tomikaa87/esp-thermostat/README.md

# esp-thermostat
Smart WiFi thermostat based on the well-known ESP8266 SoC.

Documentation and detailed description will come in the near future...
