tomikaa87/esp-thermostat/doc/CR1632-holder-HTB1.jpg

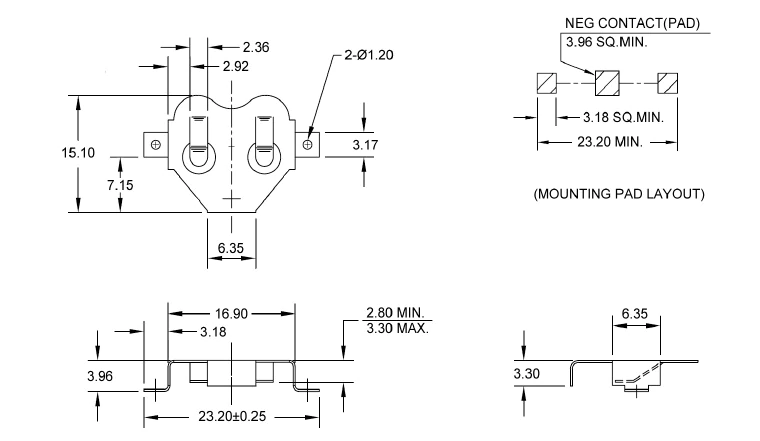
doc/CR1632-holder-HTB1.jpg
