tomikaa87/esp-thermostat/doc/oled-128x64-1.3inch.jpg

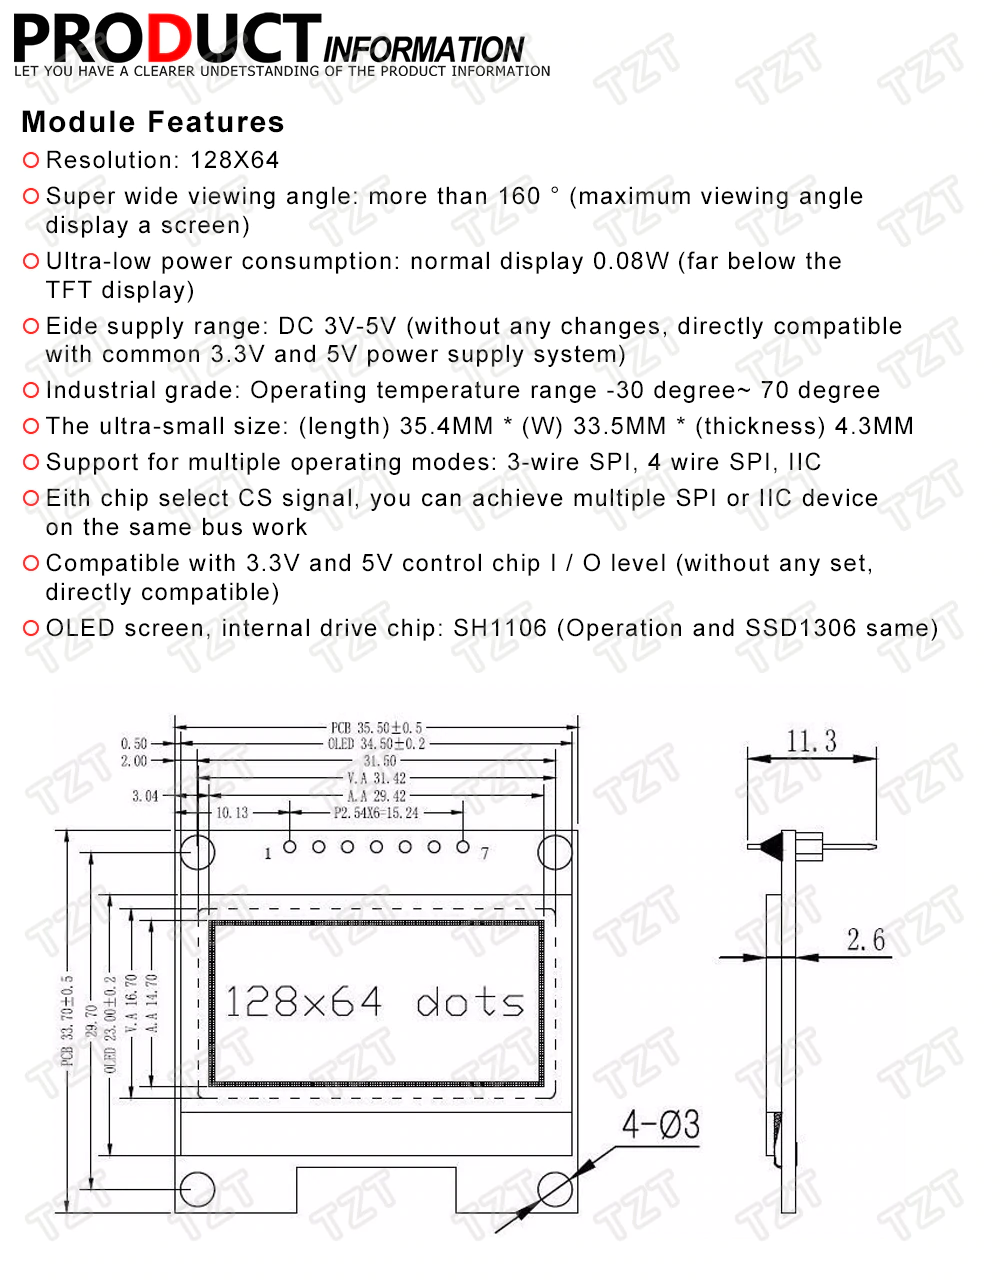
doc/oled-128x64-1.3inch.jpg
