tomikaa87/esp-thermostat/housing/esp-thermostat.FCStd

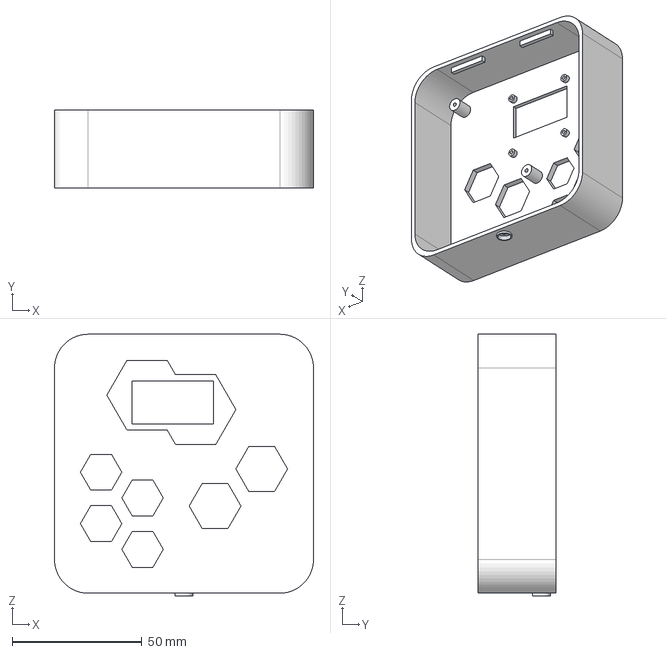
[picture p3: CAD file, 2019-12-08]
housing/esp-thermostat.FCStd
100.0 x 30.0 x 101.0 mm
