tomikaa87/esp-thermostat/pcb/esp-thermostat/ESP8266.3dshapes1/ESP-12.stl

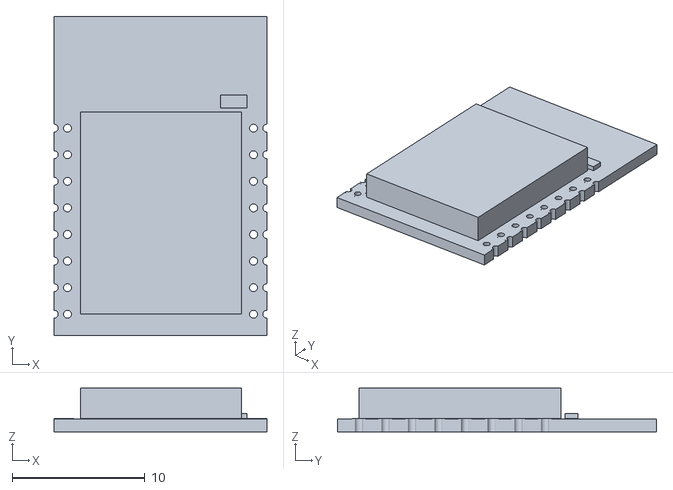
[picture p4: CAD file, 2019-11-27]
pcb/esp-thermostat/ESP8266.3dshapes1/ESP-12.stl
16.0 x 24.0 x 3.30
