tomikaa87/esp-thermostat/pcb/esp-thermostat/walter/conn_mkds/mkds_1,5-2.step

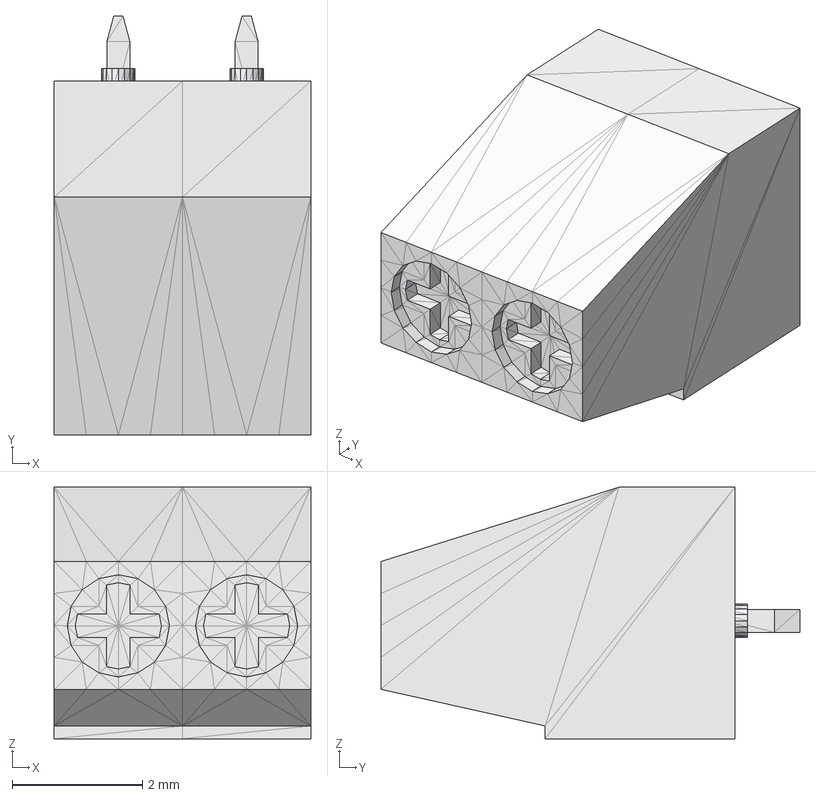
[picture p5: CAD file, 2019-11-27]
pcb/esp-thermostat/walter/conn_mkds/mkds_1,5-2.step
3.94 x 6.43 x 3.86 mm
mkds_1_5
mkds_1_006
mkds_1_007
mkds_1_008
mkds_1_009
mkds_1_010
mkds_1_011
mkds_1_012
mkds_1_013
mkds_1_014
mkds_1_015
mkds_1_016
mkds_1_017
