tomikaa87/esp-thermostat/(list of files, cad)

Other CAD files:
pcb/esp-thermostat/ESP8266.3dshapes1/ESP-12E_4wings.stl
pcb/esp-thermostat/ESP8266.3dshapes1/ESP-12_4wings.stl
pcb/esp-thermostat/ESP8266.3dshapes1/ESP-12E.stl
pcb/esp-thermostat/ESP8266.3dshapes1/ESP-12.scad
pcb/esp-thermostat/ESP8266.3dshapes1/ESP-12E.scad
pcb/esp-thermostat/walter/conn_mkds/mkds_1,5-2.stl
