tomikaa87/esp-thermostat/(threads)

Thread 2 (2024-06-16):

Please help resolve the issue with the new gree firmware: https://github.com/tomikaa87/gree-remote/issues/63

Tempmail1234-pass, 2024-06-16:

tomikaa87, 2024-10-01:
Not relevant to this project.

tomikaa87, 2024-10-01:
This issue is not relevant to the current project.

Closed 2024-10-01.
