tomikaa87/esp-thermostat/doc/switch-FSMJSM.pdf

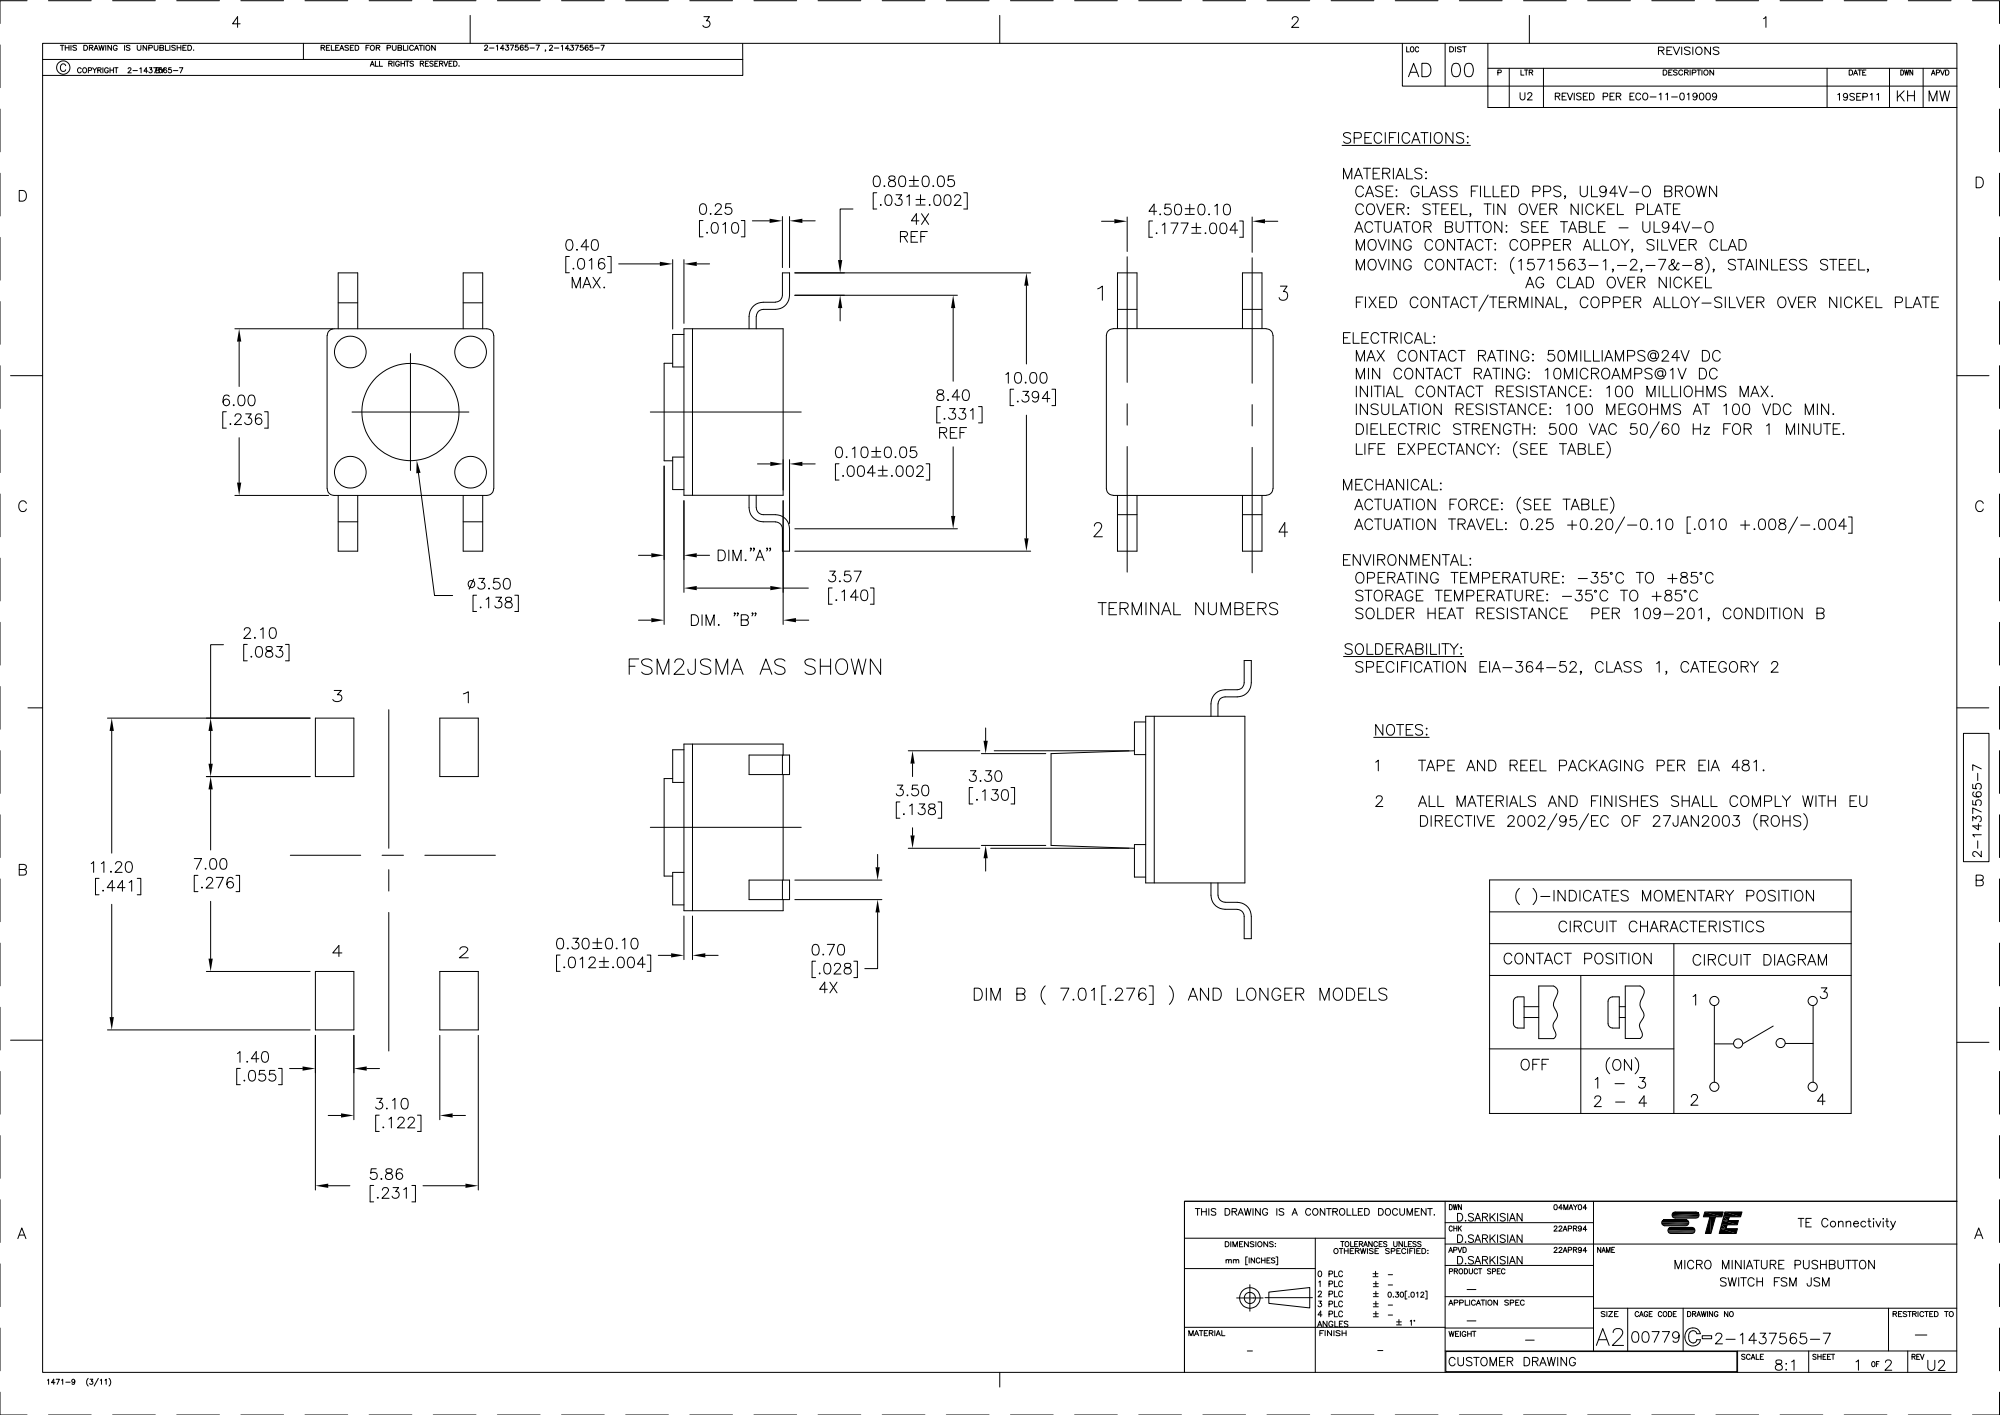
[picture p6: page 1]

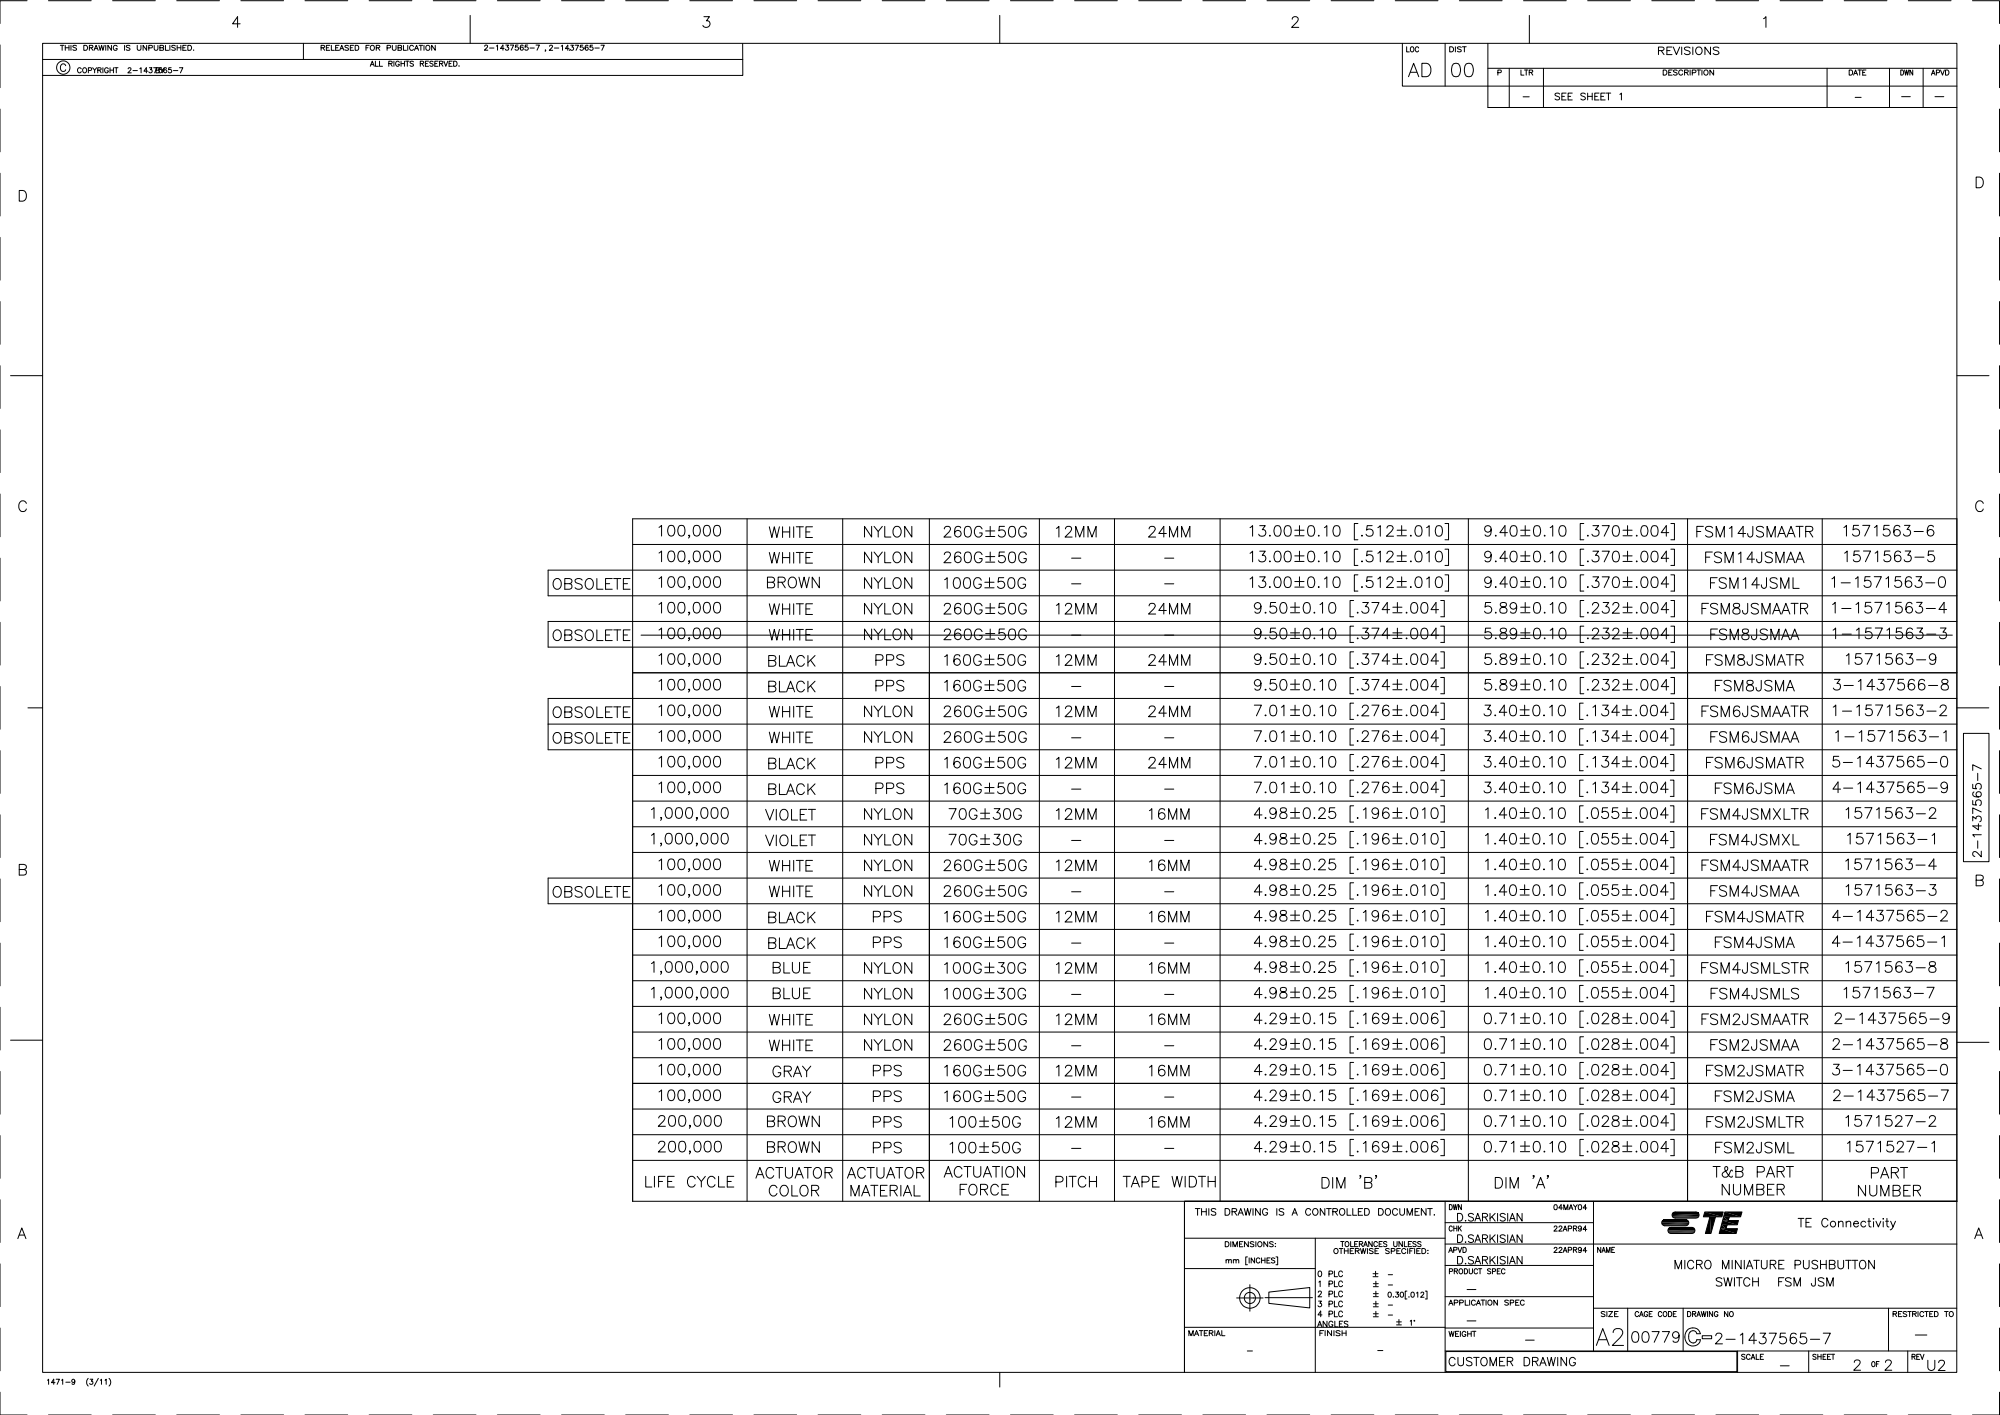
[picture p7: page 2]
