tomikaa87/esp-thermostat/pcb/esp-thermostat/esp-thermostat.kicad_pcb

## KiCad design pcb/esp-thermostat/esp-thermostat.kicad_pcb (2020-01-08)

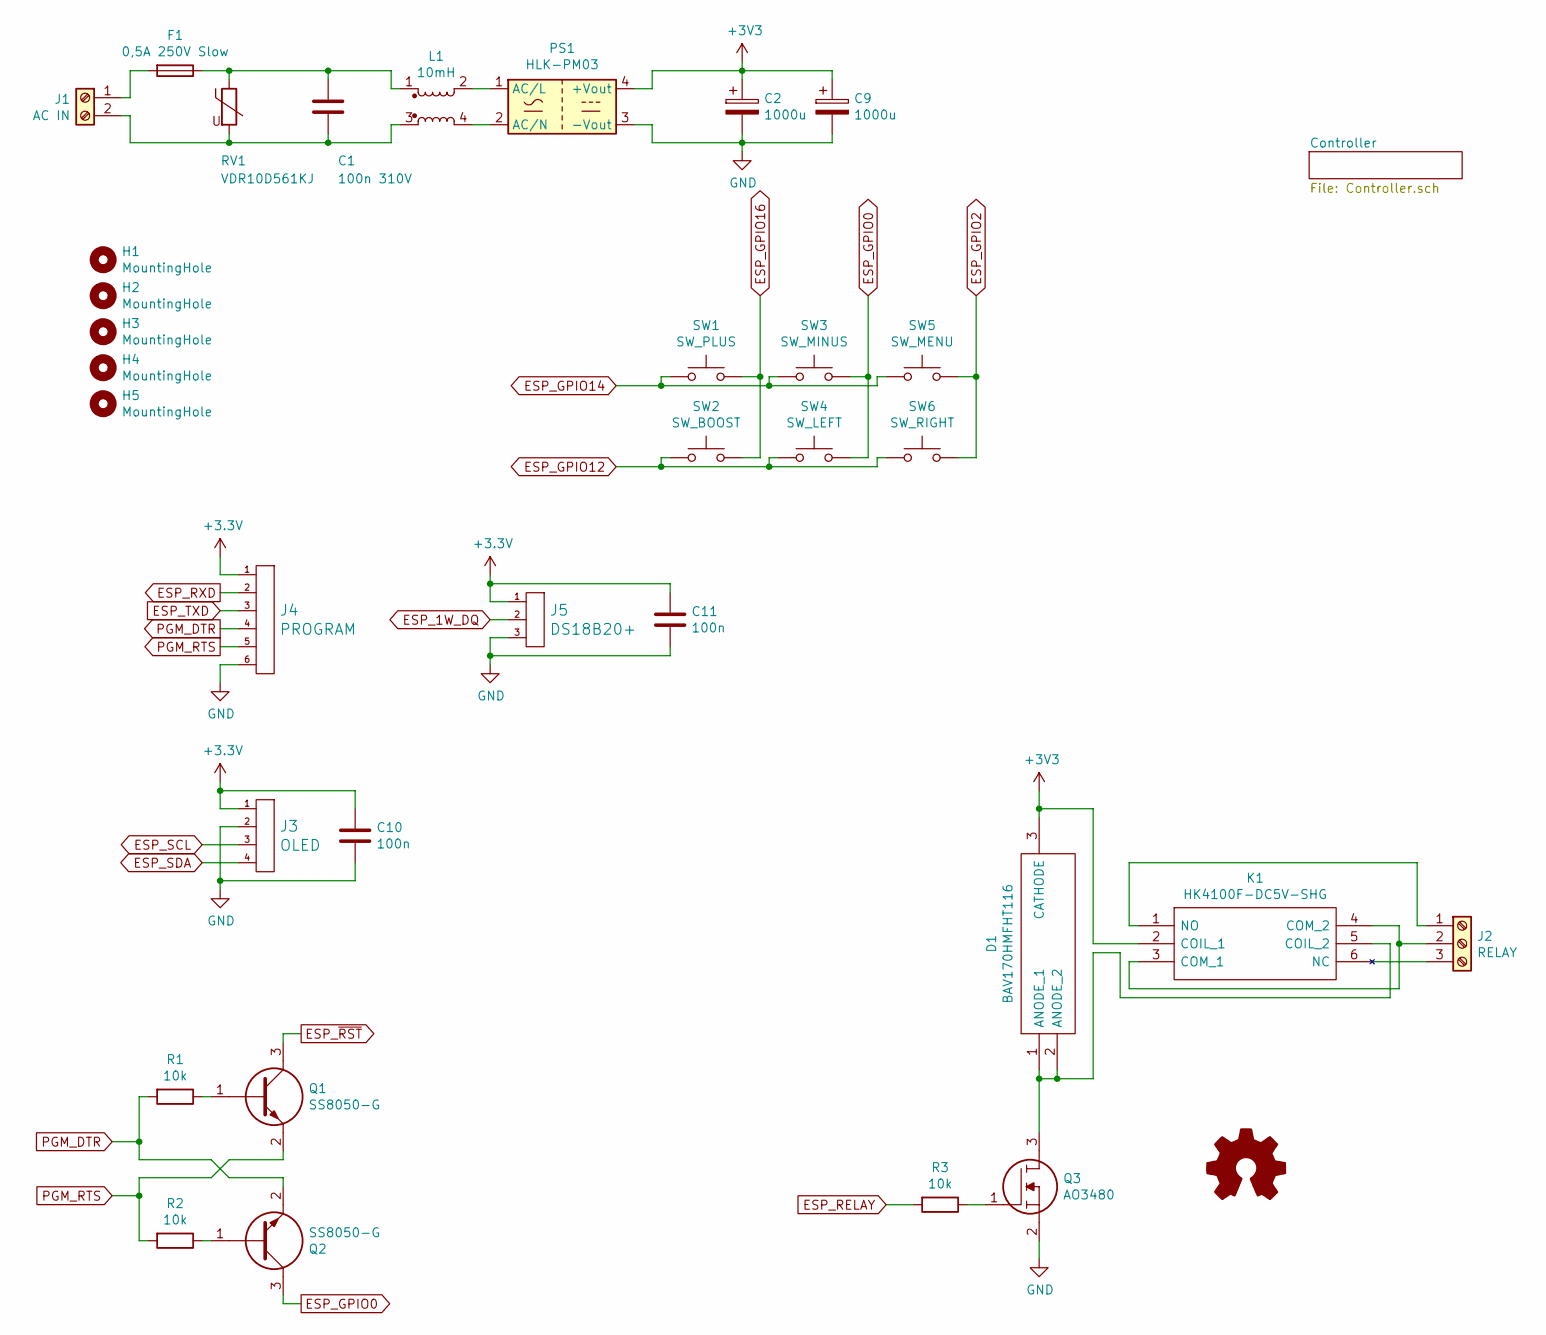
[picture p8: schematic esp-thermostat.sch]

Parts:
C1: 100n 310V; R46KI310040M1K
C2, C9: 1000u; CP_Radial_D10.0mm_P5.00mm
C10, C11: 100n; C_0805_2012Metric_Pad1.15x1.40mm_HandSolder
D1: BAV170HMFHT116; SOT95P240X115-3N; Manufacturer_Part_Number BAV170HMFHT116; Mouser Part Number 755-BAV170HMFHT116
F1: 0,5A 250V Slow; FUSC10134X305N
H1, H2, H3, H4, H5: MountingHole; MountingHole_3.2mm_M3_ISO14580_Pad
J1: AC IN; mkds_1,5-2
J2: RELAY; mkds_1,5-3
J3: OLED; PinHeader_1x04_P2.54mm_Vertical
J4: PROGRAM; PinHeader_1x06_P2.54mm_Vertical
J5: DS18B20+; PinHeader_1x03_P2.54mm_Vertical
K1: HK4100F-DC5V-SHG; HK4100FDC5VSHG; Manufacturer_Part_Number HK4100F-DC5V-SHG
L1: 10mH; UU9810MH
LOGO1: Logo_Open_Hardware_Small; OSHW-Logo2_14.6x12mm_SilkScreen
PS1: HLK-PM03; Converter_ACDC_HiLink_HLK-PMxx
Q1, Q2: SS8050-G; SOT95P240X115-3N; Manufacturer_Part_Number SS8050-G; Mouser Part Number 750-SS8050-G
Q3: AO3480; SOT95P280X125-3N; Manufacturer_Part_Number AO3480
R1, R2, R3: 10k; R_0805_2012Metric_Pad1.15x1.40mm_HandSolder
RV1: VDR10D561KJ; RV_Disc_D12mm_W6.7mm_P7.5mm
SW1: SW_PLUS; SW_Push_1P1T_NO_6x6mm_FSM2JSMA
SW2: SW_BOOST; SW_Push_1P1T_NO_6x6mm_FSM2JSMA
SW3: SW_MINUS; SW_Push_1P1T_NO_6x6mm_FSM2JSMA
SW4: SW_LEFT; SW_Push_1P1T_NO_6x6mm_FSM2JSMA
SW5: SW_MENU; SW_Push_1P1T_NO_6x6mm_FSM2JSMA
SW6: SW_RIGHT; SW_Push_1P1T_NO_6x6mm_FSM2JSMA

Connections:
ESP_1W_DQ: J5.2; also elsewhere on the board
ESP_GPIO0: Q2.3, SW3.2, SW4.2; also elsewhere on the board
ESP_GPIO2: SW5.2, SW6.2; also elsewhere on the board
ESP_GPIO12: SW2.1, SW4.1, SW6.1; also elsewhere on the board
ESP_GPIO14: SW1.1, SW3.1, SW5.1; also elsewhere on the board
ESP_GPIO16: SW1.2, SW2.2; also elsewhere on the board
ESP_RELAY: R3.2; also elsewhere on the board
ESP_RXD: J4.2; also elsewhere on the board
ESP_SCL: J3.3; also elsewhere on the board
ESP_SDA: J3.4; also elsewhere on the board
ESP_TXD: J4.3; also elsewhere on the board
ESP_~RST~: Q1.3; also elsewhere on the board
GND: C2.2, C9.2, C10.2, C11.2, J3.2, J4.6, J5.3, PS1.3 (-Vout), Q3.2; also elsewhere on the board
unnamed: C1.1, F1.1, L1.1, RV1.1
unnamed: C1.2, J1.2, L1.3, RV1.2
unnamed: D1.1 (ANODE_1), D1.2 (ANODE_2), K1.5 (COIL_2), Q3.3
unnamed: F1.2, J1.1
unnamed: J2.1, K1.1 (NO)
unnamed: J2.2, K1.3 (COM_1), K1.4 (COM_2)
unnamed: J2.3, K1.6 (NC)
unnamed: L1.2, PS1.1 (AC/L)
unnamed: L1.4, PS1.2 (AC/N)
unnamed: Q1.1, R1.1
unnamed: Q2.1, R2.1
unnamed: Q3.1, R3.1
PGM_DTR: J4.4, Q2.2, R1.2
PGM_RTS: J4.5, Q1.2, R2.2

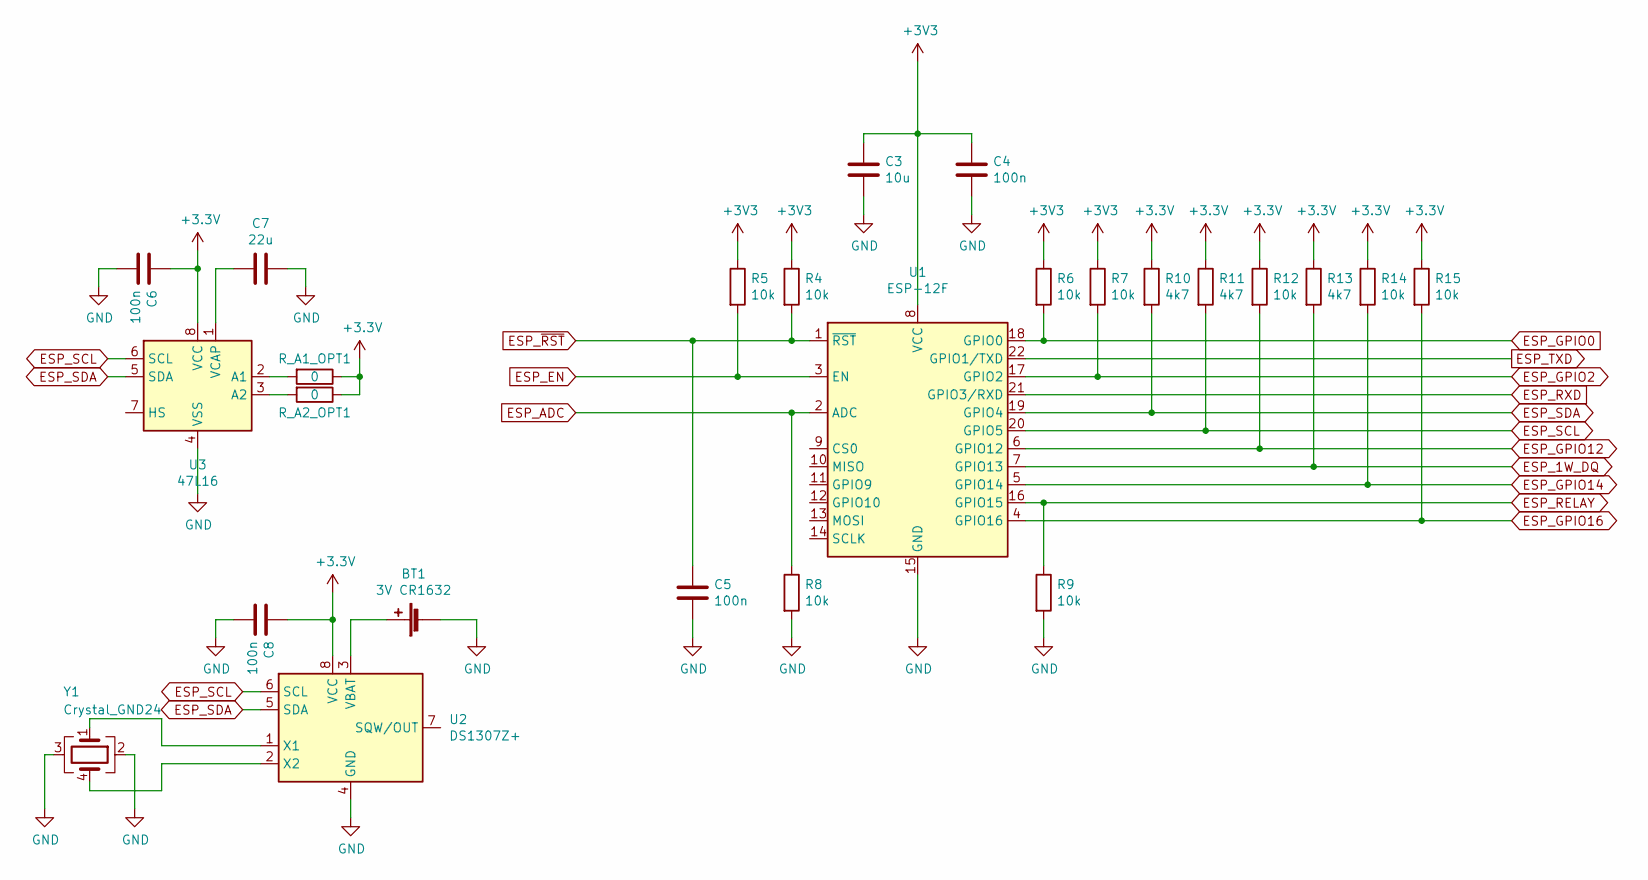
[picture p9: schematic Controller.sch]

Parts:
BT1: 3V CR1632; BatteryHolder_CR1632_SMD
C3: 10u; C_0805_2012Metric_Pad1.15x1.40mm_HandSolder
C4, C5, C6, C8: 100n; C_0805_2012Metric_Pad1.15x1.40mm_HandSolder
C7: 22u; C_0805_2012Metric_Pad1.15x1.40mm_HandSolder
R4, R5, R6, R7, R8, R9, R12, R14, R15: 10k; R_0805_2012Metric_Pad1.15x1.40mm_HandSolder
R10, R11, R13: 4k7; R_0805_2012Metric_Pad1.15x1.40mm_HandSolder
R_A1_OPT1, R_A2_OPT1: 0; R_0805_2012Metric_Pad1.15x1.40mm_HandSolder
U1: ESP-12F; ESP-12E_SMD
U2: DS1307Z+; SOIC-8_3.9x4.9mm_P1.27mm
U3: 47L16; SOIC-8_3.9x4.9mm_P1.27mm
Y1: Crystal_GND24; Crystal_SMD_SeikoEpson_MC306-4Pin_8.0x3.2mm

Connections:
ESP_1W_DQ: R13.2, U1.7 (GPIO13); also elsewhere on the board
ESP_ADC: R8.1, U1.2 (ADC)
ESP_EN: R5.2, U1.3 (EN)
ESP_GPIO0: R6.2, U1.18 (GPIO0); also elsewhere on the board
ESP_GPIO2: R7.2, U1.17 (GPIO2); also elsewhere on the board
ESP_GPIO12: R12.2, U1.6 (GPIO12); also elsewhere on the board
ESP_GPIO14: R14.2, U1.5 (GPIO14); also elsewhere on the board
ESP_GPIO16: R15.2, U1.4 (GPIO16); also elsewhere on the board
ESP_RELAY: R9.1, U1.16 (GPIO15); also elsewhere on the board
ESP_RXD: U1.21 (GPIO3/RXD); also elsewhere on the board
ESP_SCL: R11.2, U1.20 (GPIO5), U2.6 (SCL), U3.6 (SCL); also elsewhere on the board
ESP_SDA: R10.2, U1.19 (GPIO4), U2.5 (SDA), U3.5 (SDA); also elsewhere on the board
ESP_TXD: U1.22 (GPIO1/TXD); also elsewhere on the board
ESP_~RST~: C5.1, R4.2, U1.1 (~RST); also elsewhere on the board
GND: BT1.2 (-), C3.2, C4.2, C5.2, C6.2, C7.1, C8.2, R8.2, R9.2, U1.15 (GND), U2.4 (GND), U3.4 (VSS), Y1.2, Y1.3; also elsewhere on the board
unnamed: BT1.1 (+), U2.3 (VBAT)
unnamed: C7.2, U3.1 (VCAP)
unnamed: R_A1_OPT1.2, U3.2 (A1)
unnamed: R_A2_OPT1.2, U3.3 (A2)
unnamed: U2.1 (X1), Y1.1
unnamed: U2.2 (X2), Y1.4

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
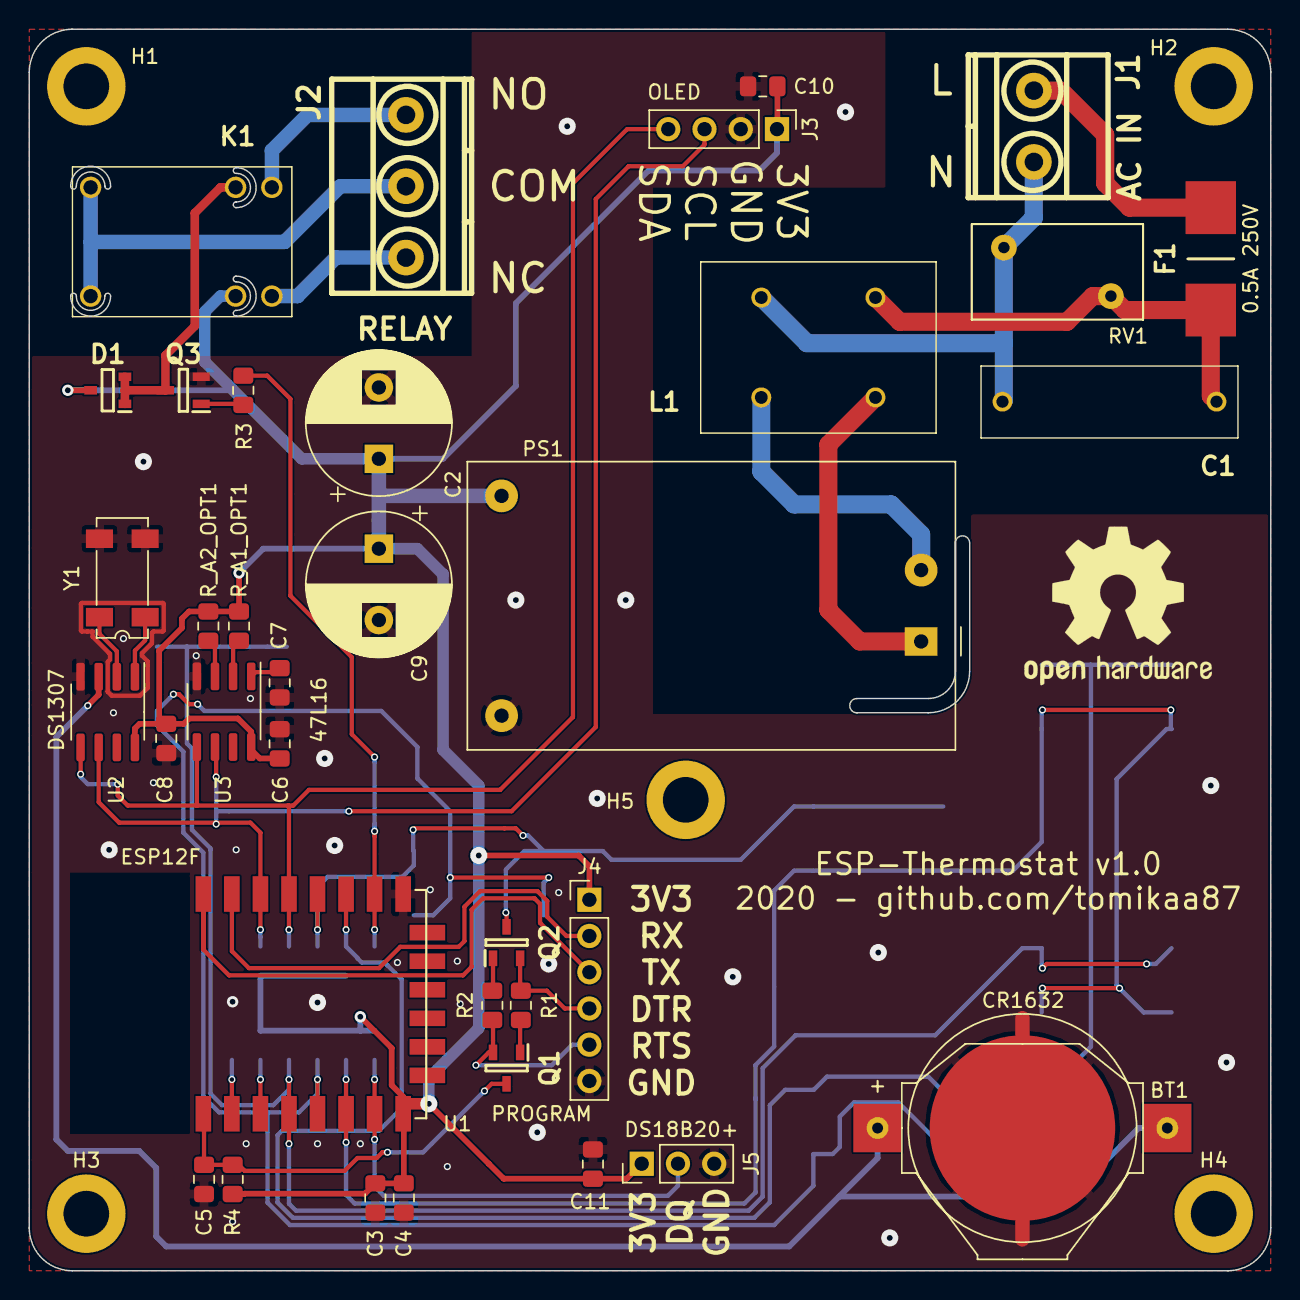
[picture p10: board esp-thermostat.kicad_pcb from above]

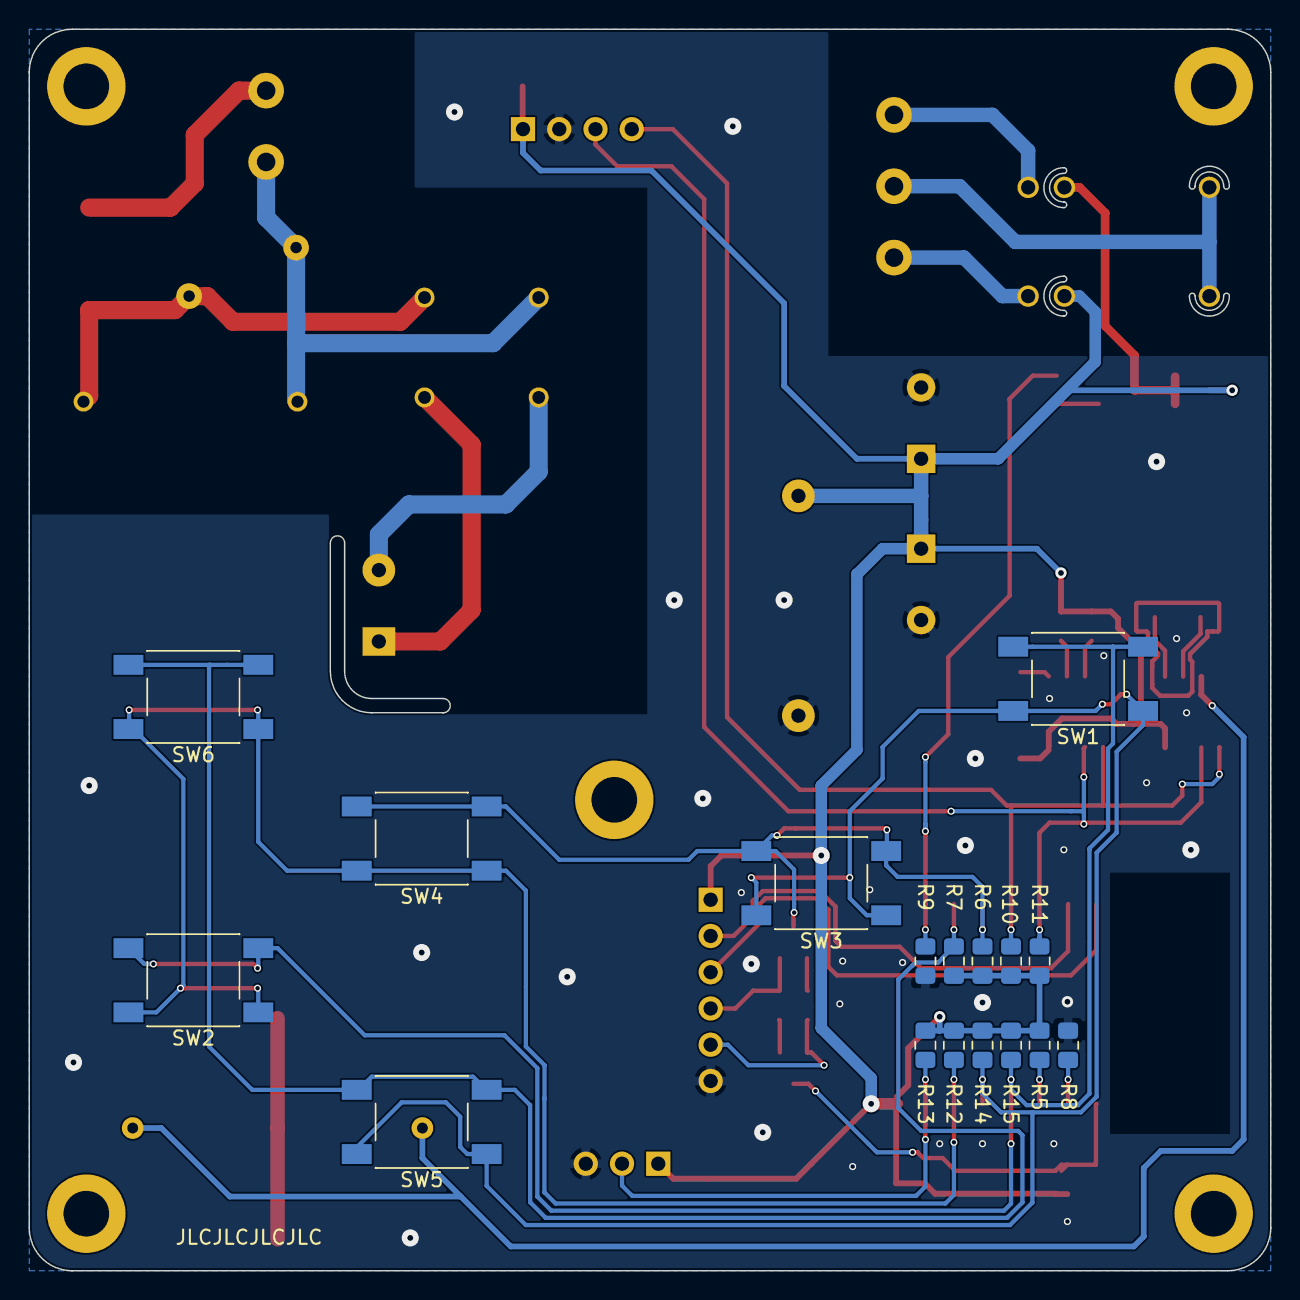
[picture p11: board esp-thermostat.kicad_pcb from below]

Board: 2 copper layers, 87.0 x 87.0 mm, 59 parts (17 on the bottom side), 36 nets.
