tomikaa87/esp-thermostat/src/main.cpp

#include "main.h"
#include "Config.h"
#include "FurnaceController.h"
#include "Peripherals.h"
#include "Settings.h"

#include "ui/Model.h"
#include "ui/UIController.h"

#include <Arduino.h>
#include <CoreApplication.h>

#include <memory>

namespace
{
    ApplicationConfig appConfig;
    CoreApplication* coreApplication{};
    Settings* settings{};
    UI::Model* uiModel{};
    FurnaceController* furnaceController{};
    UI::UIController* uiController{};
}

void initializeTempSensor()
{
    // Force a new conversion and wait for the results
    Peripherals::Sensors::MainTemperature::update(true);
    delay(800); // Max. 750 ms for 12-bit
    Peripherals::Sensors::MainTemperature::update();
}

void setup()
{
    initializeTempSensor();

    appConfig.firmwareVersion = VersionNumber{ 1, 8, 0 };

#ifndef TEST_BUILD
    appConfig.logging.syslog.enabled = true;
    appConfig.logging.syslog.hostName = Config::Logging::SyslogHostName;
    appConfig.logging.syslog.server = Config::Logging::SyslogServer;
    appConfig.logging.syslog.serverPort = Config::Logging::SyslogServerPort;
#endif

    appConfig.mqtt.enabled = Config::Mqtt::Enabled;
    if (Config::Mqtt::Enabled) {
        appConfig.mqtt.id = Config::Mqtt::Id;
        appConfig.mqtt.broker = Config::Mqtt::Broker;
        appConfig.mqtt.brokerPort = Config::Mqtt::BrokerPort;
        appConfig.mqtt.user = Config::Mqtt::User;
        appConfig.mqtt.password =  Config::Mqtt::Password;
    }

#ifdef IOT_ENABLE_HTTP_OTA_UPDATE
    appConfig.otaUpdate.updateCheckIntervalMs = 60000;
    appConfig.otaUpdate.updateUrl = Config::OtaUpdate::FirmwareUpdateUrl;
#endif
    appConfig.otaUpdate.arduinoOtaPasswordHash = Config::OtaUpdate::ArduinoOtaPasswordHash;

    appConfig.wifi.password = Config::WiFi::Password;
    appConfig.wifi.ssid = Config::WiFi::SSID;

    appConfig.ntp.server = Config::Ntp::Server;

    appConfig.hostName = Config::HostName;

    coreApplication = [] {
        static CoreApplication application{ appConfig };
        return &application;
    }();

    settings = [] {
        static Settings s{ coreApplication->settings() };
        return &s;
    }();

    appConfig.logging.maximumLevel = static_cast<Log::Severity>(settings->system.maximumLogLevel);

    uiModel = [] {
        static UI::Model model{ .settings = *settings };
        return &model;
    }();

    furnaceController = [] {
        static FurnaceController controller{ *coreApplication, appConfig, *settings, *uiModel };
        return &controller;
    }();

    uiController = [] {
        static UI::UIController controller{ *coreApplication, *settings, *uiModel };
        return &controller;
    }();
}

void loop()
{
    static uint32_t lastTaskMillis{};

    const uint32_t currentMillis{ millis() };
    const uint32_t deltaMillis{ currentMillis - lastTaskMillis };
    lastTaskMillis = currentMillis;

    coreApplication->task();
    furnaceController->task(deltaMillis);
    uiController->task(deltaMillis);
}
