tomikaa87/esp-thermostat/src/FurnaceController.h

#pragma once

#include "Config.h"
#include "HeatingZone.h"
#include "Settings.h"
#include "TemperatureSensor.h"

#include <CoreApplication.h>
#include <Logger.h>

#include <network/MQTT/MqttVariable.h>

#include <array>
#include <cstdint>

class ApplicationConfig;

namespace UI
{
    struct Model;
}

class FurnaceController
{
public:
    explicit FurnaceController(
        CoreApplication& application,
        const ApplicationConfig& appConfig,
        Settings& settings,
        UI::Model& uiModel
    );

    void task(uint32_t deltaMillis);

private:
    const ApplicationConfig& _appConfig;
    CoreApplication& _app;
    Settings& _settings;
    UI::Model& _uiModel;
    Logger _log{ "FurnaceController" };
    std::array<HeatingZone, Config::ZoneCount> _zones;
    TemperatureSensor _temperatureSensor;
    uint32_t _mqttUpdateTimer{};
    uint32_t _clockUpdateTimer{};
    bool _relayOutputActive{ false };

    std::string _topicPrefix;
    MqttVariable<int> _masterSwitch;
    MqttVariable<int> _energyOptimizerSwitch;
    MqttVariable<int> _callingForHeatingState;

    void setupRelayOutput() const;
    void setRelayOutputActive(bool active);

    void setupMqttComponentConfigs();
    void setupMqttChangeHandlers();
    void updateMqtt();

    void updateUiModel();
};
