tomikaa87/esp-thermostat/src/wifi_screen.cpp

/*
    This file is part of esp-thermostat.

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
    Author: Tamas Karpati
    Created on 2020-01-08
*/

#include "keypad.h"
#include "text_input.h"
#include "wifi_screen.h"

#include "display/Display.h"
#include "display/Text.h"

#include <string.h>
#include <stdio.h>

/*
    Main screen:

    WiFi Connection
    Connected to:
    <SSID>
    IP: 000.000.000.000

    > Disconnect
      Scan
      Leave


    Scan screen (scanning):

    WiFi Networks:
    
    Scanning...

    > Abort


    Scan screen (found networks):

    WiFi Networks:
    > SSID 1
      SSID 2
      SSID 3
      SSID 4
      SSID 5
      Back
      


*/

typedef enum {
    SCR_MAIN,
    SCR_SCAN,
    SCR_PASSWORD
} screen_t;

typedef enum {
    SCN_IDLE,
    SCN_SCANNING,
    SCN_FINISHED
} scan_state_t;

static struct state_s {
    int ap_cnt;
    char ap_psk[64];
    char ap_ssid[32];
    int list_pos;
    int list_offs;
    screen_t screen;
    scan_state_t scan;
} state;

static struct cb_s {
    wifi_scan_cb scan;
    wifi_read_ssid_cb read_ssid;
    wifi_is_open_cb is_open;
} callbacks;

static void draw();
static void update();
static void select_item();
static void init_scan();

void wifi_screen_set_scan_cb(wifi_scan_cb cb)
{
    callbacks.scan = cb;
}

void wifi_screen_set_read_ssid_cb(wifi_read_ssid_cb cb)
{
    callbacks.read_ssid = cb;
}

void wifi_screen_set_is_open_cb(wifi_is_open_cb cb)
{
    callbacks.is_open = cb;
}

void wifi_screen_init()
{
    printf("wifi_screen::init\n");

    memset(&state, 0, sizeof(struct state_s));

    draw();
}

void wifi_screen_update()
{
    printf("wifi_screen::update\n");
}

void wifi_screen_leave()
{
    printf("wifi_screen::leave\n");
}

void wifi_screen_key_event(Keypad::Keys keys)
{
    printf("wifi_screen::key_event: keys=0x%x\n", keys);

    bool update_needed = false;

    switch (state.screen) {
    case SCR_MAIN:
        // + -> Down
        if (keys & Keypad::Keys::Plus) {
            if (++state.list_pos >= 3) {
                state.list_pos = 0;
            }
            update_needed = true;
        // - -> Up
        } else if (keys & Keypad::Keys::Minus) {
            if (state.list_pos == 0) {
                state.list_pos = 2;
            } else {
                --state.list_pos;
            }
            update_needed = true;
        // Right -> Select
        } else if (keys & Keypad::Keys::Right) {
            select_item();
        }
        break;

    case SCR_SCAN:
        // + -> Down
        if (keys & Keypad::Keys::Plus) {
            if (state.list_pos < state.ap_cnt) {
                ++state.list_pos;
                if (state.list_pos - state.list_offs > 6) {
                    ++state.list_offs;
                }
            }
            update_needed = true;
        // - -> Up
        } else if (keys & Keypad::Keys::Minus) {
            if (state.list_pos > 0) {
                --state.list_pos;
                if (state.list_pos - state.list_offs < 0) {
                    --state.list_offs;
                }
            }
            update_needed = true;
        } else if (keys & Keypad::Keys::Right) {
            select_item();
        }

    case SCR_PASSWORD: {
        ti_key_event_t key_event;
        bool valid_key = true;

        if (keys & Keypad::Keys::Plus) {
            key_event = TI_KE_UP;
        } else if (keys & Keypad::Keys::Minus) {
            key_event = TI_KE_DOWN;
        } else if (keys & Keypad::Keys::Menu) {
            key_event = TI_KE_SELECT;
        } else if (keys & Keypad::Keys::Left) {
            key_event = TI_KE_LEFT;
        } else if (keys & Keypad::Keys::Right) {
            key_event = TI_KE_RIGHT;
        } else {
            valid_key = false;
        }

        if (valid_key) {
            const ti_key_event_result_t res = text_input_key_event(key_event);

            switch (res) {
            case TI_KE_ACCEPT:
                printf("wifi_screen: password entered: %s\n", state.ap_psk);
                state.screen = SCR_MAIN;
                draw();
                break;

            case TI_KE_CANCEL:
                printf("wifi_screen: password input canceled\n");
                state.screen = SCR_SCAN;
                draw();
                break;

            default:
                break;
            }
        }
        break;
    }        
    }

    if (update_needed) {
        update();
    }
}

static void draw()
{
    printf("wifi_screen::draw: screen=%d\n", state.screen);

    Display::clear();

    switch (state.screen) {
    case SCR_MAIN:
        Text::draw("WiFi Connection", 0, 0, 0, false);
        Text::draw("Connected to:", 1, 0, 0, false);
        Text::draw("IP:", 3, 0, 0, false);
        Text::draw("Disconnect", 5, 10, 0, false);
        Text::draw("Scan", 6, 10, 0, false);
        Text::draw("Leave", 7, 10, 0, false);
        break;

    case SCR_SCAN:
        Text::draw("WiFi Networks", 0, 0, 0, false);
        switch (state.scan) {
        case SCN_IDLE:
            Text::draw("Idle", 2, 10, 0, false);
            break;

        case SCN_SCANNING:
            Text::draw("Scanning...", 2, 10, 0, false);
            break;
        }
        break;

    case SCR_PASSWORD:
        text_input_init(state.ap_psk, sizeof(state.ap_psk), "WiFi Password:");
        break;
    }

    update();
}

static void update()
{
    printf("wifi_screen::update: screen=%d\n", state.screen);

    switch (state.screen) {
    case SCR_MAIN:
        for (int i = 0; i < 3; ++i) {
            Text::draw(i == state.list_pos ? ">" : " ", i + 5, 0, 0, false);
        }
        break;

    case SCR_SCAN:
        switch (state.scan) {
        case SCN_FINISHED:
            for (int i = state.list_offs, line = 1; i < state.ap_cnt + 1 && i - state.list_offs < 7; ++i, ++line) {
                printf("wifi_screen::update: drawing AP list item, i=%d, list_pos=%d, list_offs=%d, line=%d\n",
                    i, state.list_pos, state.list_offs, line
                );

                // Clear the row
                Display::setColumn(10);
                Display::setLine(line);
                for (int i = 0; i < 118; ++i) {
                    static const uint8_t pattern = 0;
                    Display::sendData(&pattern, 1, 0, false);
                }

                if (i == 0) {
                    Text::draw("<< Back", line, 10, 0, false);
                } else {
                    if (callbacks.read_ssid) {
                        char buf[32] = { 0 };
                        callbacks.read_ssid(i - 1, buf);
                        Text::draw(buf, line, 10, 0, false);
                    }
                }
                Text::draw(i == state.list_pos ? ">" : " ", line, 0, 0, false);
            }
            break;
        }
        break;
    }
}

static void select_item()
{
    printf("wifi_screen::select_item: %d\n", state.list_pos);

    switch (state.screen) {
    case SCR_MAIN:
        if (state.list_pos == 0) {
            // Disconnect
        } else if (state.list_pos == 1) {
            // Scan
            state.screen = SCR_SCAN;
            draw();
            init_scan();
        } else if (state.list_pos == 2) {
            // Leave
        }
        break;

    case SCR_SCAN:
        if (state.list_pos == 0) {
            // Back
            state.screen = SCR_MAIN;
            draw();
        } else {
            // Select SSID
            if (callbacks.read_ssid) {
                callbacks.read_ssid(state.list_pos - 1, state.ap_ssid);
                printf("wifi_screen::select_item: selected SSID: %s\n", state.ap_ssid);
            }

            if (callbacks.is_open) {
                if (!callbacks.is_open(state.list_pos - 1)) {
                    printf("wifi_screen::select_item: selected AP requires password\n");
                    state.screen = SCR_PASSWORD;
                    text_input_init(state.ap_psk, sizeof(state.ap_psk), "Enter password:");
                } else {
                    state.screen = SCR_MAIN;
                    printf("wifi_screen::select_item: selected AP is open\n");
                    draw();
                }
            }
        }
        break;
    }
}

static void init_scan()
{
    printf("wifi_screen::init_scan\n");

    state.scan = SCN_IDLE;
    state.ap_cnt = 0;
    state.list_offs = 0;

    update();

    if (callbacks.scan) {
        state.scan = SCN_SCANNING;
        update();
        printf("wifi_screen::init_scan: scanning\n");
        state.ap_cnt = callbacks.scan();
        printf("wifi_screen::init_scan: finished, count=%d\n", state.ap_cnt);
        state.scan = SCN_FINISHED;
        update();
    } else {
        printf("wifi_screen::init_scan: scan callback is null\n");
    }
}
