tomikaa87/esp-thermostat/src/draw_helper.cpp

/*
    This file is part of esp-thermostat.

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
    Author: Tamas Karpati
    Created on 2017-01-07
*/

#include "draw_helper.h"
#include "graphics.h"
#include "extras.h"

#include "display/Display.h"
#include "display/Text.h"

#include <stdio.h>

void draw_weekday(uint8_t x, uint8_t wday)
{
    if (wday > 6)
        return;

    static const char days[7][4] = {
        "SUN",
        "MON",
        "TUE",
        "WED",
        "THU",
        "FRI",
        "SAT"
    };

    Text::draw(days[wday], 0, x, 0, false);
}

void draw_mode_indicator(mode_indicator_t indicator)
{
    switch (indicator) {
    case DH_MODE_HEATING:
        graphics_draw_multipage_bitmap(graphics_flame_icon_20x3p, 20, 3, 92, 2);
        break;

    case DH_MODE_OFF:
        graphics_draw_multipage_bitmap(graphics_off_icon_20x3p, 20, 3, 92, 2);
        break;

    default:
        Display::fillArea(92, 2, 20, 3, 0);
        break;
    }
}

void draw_schedule_bar(schedule_day_data sday)
{
    static const uint8_t long_tick = 0b11110000;
    static const uint8_t short_tick = 0b01110000;
    static const uint8_t bar_indicator = 0b00010111;
    static const uint8_t bar_no_indicator = 0b00010000;

    Display::setLine(6);
    Display::setColumn(3);

    uint8_t tick_counter = 0;
    uint8_t long_tick_counter = 0;
    uint8_t schedule_byte_idx = 0;
    uint8_t schedule_bit_idx = 255; // Will overflow in the first round
    uint8_t indicator_counter = 0;
    uint8_t schedule_bit = 0;

    for (uint8_t x = 0; x < 121; ++x) {
        uint8_t bitmap;

        if (tick_counter == 0) {
            // Draw ticks
            if (long_tick_counter == 0)
                bitmap = long_tick;
            else
                bitmap = short_tick;
        } else {
            // Draw rest of the bar with or without the indicators
            if (indicator_counter < 2 && schedule_bit)
                bitmap = bar_indicator;
            else
                bitmap = bar_no_indicator;
        }

        Display::sendData(bitmap);

        if (++tick_counter == 5) {
            tick_counter = 0;
            if (++long_tick_counter == 6)
                long_tick_counter = 0;
        }

        ++indicator_counter;
        if (tick_counter == 1 || tick_counter == 3) {
            indicator_counter = 0;
            if (++schedule_bit_idx == 8) {
                ++schedule_byte_idx;
                schedule_bit_idx = 0;
            }

            schedule_bit = (sday[schedule_byte_idx] >> schedule_bit_idx) & 1;
        }
    }

    Text::draw("0", 7, 1, 1, false);
    Text::draw("6", 7, 31, 1, false);
    Text::draw("12", 7, 58, 1, false);
    Text::draw("18", 7, 88, 1, false);
    Text::draw("24", 7, 115, 1, false);
}

void draw_schedule_indicator(uint8_t sch_intval_idx)
{
    static const uint8_t indicator_bitmap[] = {
        0b00010000,
        0b00100000,
        0b01111100,
        0b00100000,
        0b00010000
    };

    uint8_t x = 2; // initial offset from left
    x += sch_intval_idx << 1;	// for every "tick"
    x += sch_intval_idx >> 1;	// for every padding between "ticks"

    /*
     0:     v
     1:     . v
     2:     . .  v
     3:     . .  . v
     4:     . .  . .  v
     5:     . .  . .  . v
            |||| |||| ||||
            01234567890123

        0 -> 0
        1 -> 2
        2 -> 5
        3 -> 7
        4 -> 10
        5 -> 12
     */

    Display::fillArea(0, 5, 128, 1, 0);

    graphics_draw_bitmap(indicator_bitmap, sizeof(indicator_bitmap), x, 5);
}

void draw_temperature_value(uint8_t x, int8_t int_part, int8_t frac_part)
{
    if (int_part < 0 || frac_part < 0)
        Text::draw7Seg("-", 2, x - 13);
    else
        Text::draw7Seg(" ", 2, x - 13);

    // Draw integral part of the value
    char s[3] = { 0 };
    sprintf(s, "%02d", int_part >= 0 ? int_part : -int_part);
    Text::draw7Seg(s, 2, x);

    // Draw the decimal point
    static const uint8_t dp_bitmap[] = { 0b01100000, 0b01100000 };
    Display::setLine(4);
    Display::setColumn(x + 28);
    Display::sendData(dp_bitmap, sizeof(dp_bitmap), 0, false);

    // Draw fractional part of the value
    sprintf(s, "%d", frac_part >= 0 ? frac_part : -frac_part);
    Text::draw7Seg(s, 2, x + 32);

    // Draw the degree symbol
    static const uint8_t ds_bitmap[6] = {
        0b00011110,
        0b00101101,
        0b00110011,
        0b00110011,
        0b00101101,
        0b00011110
    };

    Display::setLine(2);
    Display::setColumn(x + 48);
    Display::sendData(ds_bitmap, sizeof(ds_bitmap), 1, false);

    // Draw temperature unit
    Text::draw7Seg("C ", 2, x + 56);
}
