tomikaa87/esp-thermostat/src/IntellisenseClang.h

// This file should be added to Forced Includes NMake option to fix IntelliSense parsing issues

#pragma once

#ifdef _MSC_VER
#define __asm__(x)
#define __extension__(x)
#define __attribute__(x)
#define __builtin_va_list int
#define __extension__
#define __inline__
#define __builtin_constant_p
#define _Bool bool
#undef __cplusplus
#define __cplusplus 201103L
#endif
