tomikaa87/esp-thermostat/src/ui.c

/*
    This file is part of esp-thermostat.

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
    Author: Tamas Karpati
    Created on 2017-01-07
*/

#include "config.h"
#include "ui.h"
#include "keypad.h"
#include "settings.h"
#include "clock.h"

#ifndef CONFIG_USE_OLED_SH1106
#include "ssd1306.h"
#else
#include "sh1106.h"
#endif

#include "main_screen.h"
#include "menu_screen.h"
#include "scheduling_screen.h"

#include <stdbool.h>
#include <string.h>
#include <stdio.h>
#include <time.h>

// #define ENABLE_DEBUG

static void update_display_active_state();
static bool is_ui_active();

static struct ui_s {
	enum {
		SCR_MAIN = 0,
		SCR_MENU,
		SCR_SCHEDULING
	} screen;

	time_t last_keypress_time;
} ui;

void ui_init()
{
	memset(&ui, 0, sizeof(struct ui_s));

#ifndef CONFIG_USE_OLED_SH1106
	ssd1306_init();
	ssd1306_set_brightness(settings.display.brightness);
#else
	sh1106_init();
	sh1106_set_contrast(settings.display.brightness);
#endif

	main_screen_init();
	main_screen_draw();
}

void ui_update()
{
	switch (ui.screen) {
	case SCR_MAIN:
		main_screen_update();
		break;

	case SCR_MENU:
		break;

	case SCR_SCHEDULING:
		break;
	}

	update_display_active_state();
}

void ui_handle_keys(uint16_t keys)
{
	static uint16_t last_keys = 0;
	if (last_keys != keys) {
#ifdef ENABLE_DEBUG
		printf("keys: %04X\r\n", keys);
#endif
		last_keys = keys;
	}

	if (keys == 0)
		return;

	ui.last_keypress_time = clock_epoch;

	// If the display is sleeping, use this keypress to wake it up,
	// but don't interact with the UI while it's invisible.
#ifndef CONFIG_USE_OLED_SH1106	
	if (!ssd1306_is_display_enabled()) {
#else
	if (!sh1106_is_display_on()) {
#endif
		return;
	}

	ui_result result = UI_RESULT_IDLE;

	switch (ui.screen) {
	case SCR_MAIN:
		result = main_screen_handle_keys(keys);
		break;

	case SCR_MENU:
		result = menu_screen_handle_handle_keys(keys);
		break;

	case SCR_SCHEDULING:
		result = scheduling_screen_handle_keys(keys);
		break;
	}

#ifdef ENABLE_DEBUG
	printf("ui_result=%d\r\n", result);
#endif

	if (result == UI_RESULT_IDLE)
		return;

	if (result == UI_RESULT_UPDATE) {
		ui_update();
		return;
	}

	// Clear the screen before switching
#ifndef CONFIG_USE_OLED_SH1106
	ssd1306_clear();
#else
	sh1106_clear();
#endif

	switch (result) {
	case UI_RESULT_SWITCH_MAIN_SCREEN:
		ui.screen = SCR_MAIN;
		main_screen_draw();
		break;

	case UI_RESULT_SWITCH_MENU_SCREEN:
		ui.screen = SCR_MENU;
		menu_screen_init();
		menu_screen_draw();
		break;

	case UI_RESULT_SWITCH_SCHEDULING_SCREEN:
		ui.screen = SCR_SCHEDULING;
		scheduling_screen_init();
		scheduling_screen_draw();
		break;
	}

#ifdef ENABLE_DEBUG
	printf("ui.screen=%d\r\n", ui.screen);
#endif
}

static void update_display_active_state()
{
#ifndef CONFIG_USE_OLED_SH1106
	if (is_ui_active()) {
		if (!ssd1306_is_display_enabled()) {
			ssd1306_set_display_enabled(1);
		}
	} else {
		if (ssd1306_is_display_enabled()) {
			ssd1306_set_display_enabled(0);
		}
	}
#else
	if (is_ui_active()) {
		if (!sh1106_is_display_on()) {
			sh1106_set_display_on(true);
		}
	} else {
		if (sh1106_is_display_on()) {
			sh1106_set_display_on(false);
		}
	}
#endif
}

static bool is_ui_active()
{
	if (settings.display.timeout_secs == 0) {
		return true;
	}

	return (clock_epoch - ui.last_keypress_time) < (time_t)(settings.display.timeout_secs);
}
