tomikaa87/esp-thermostat/(commit log)

2019-11-30 Housing: add buttons
    [esp-thermostat.FCStd]
2019-11-30 Housing: add OLED dummy model
    [esp-thermostat.FCStd]
2019-11-30 Housing: add backplate
    [esp-thermostat.FCStd]
2019-11-30 Housing: begin resizing to 100x100
    [esp-thermostat.FCStd]
2019-12-01 Housing: finish resizing, buttons still missing
    [esp-thermostat.FCStd]
2019-12-01 Housing: resize buttons
    [esp-thermostat.FCStd]
2019-12-01 Housing: shrink button texts
    [esp-thermostat.FCStd]
2019-12-08 Route PCB for 100x100 housing
    [esp-thermostat.FCStd]
2019-12-22 Small improvements on the PCB
    [esp-thermostat.kicad_pcb]
2019-12-28 PCB: add temp sensor header, optimize routing
    [Controller.sch, esp-thermostat.kicad_pcb, esp-thermostat.sch]
2019-12-28 Housing: add PCB model, add top vent holes and dust shield
2020-01-04 PCB: prepare for manufacturing
    [esp-thermostat.kicad_pcb, esp-thermostat.sch]
2020-01-08 Finalize PCB, ready for manufacturing
    [esp-thermostat.kicad_pcb]
2020-01-08 Finalize the housing
2020-01-08 Housing: add Mefisto 0.4 mesh
2020-01-22 Initial commit of new display drivers
2020-01-24 Implement new SSD1306 driver
2020-02-23 Adjust housing sizes
2020-02-23 Add new c++-based drivers
2020-02-23 Add missing license headers
    [BusConfig.h, DS18B20.cpp, DS18B20.h, Display.h, Driver_SH1106.cpp, Driver_SH1106.h, Driver_SSD1306.cpp, Driver_SSD1306.h]
2020-02-23 Fix EERAM driver
2020-02-24 Initial commit of MCP7940N RTC driver
2020-02-27 Integrate new RTC driver
2020-02-28 Stabilize temperature readings
2020-03-07 Modernize keypad driver implementation
2020-03-07 Remove remains of old keypad driver
2020-03-07 Use new display drivers everywhere
2020-04-13 Improve Settings, implement more efficient I2C driver, fix minor issues
    [DS18B20.cpp, DS18B20.h, Driver_SH1106.cpp, Driver_SSD1306.cpp, OneWire.cpp, SimpleI2C.h, main.cpp]
2020-08-18 (FIXME) improve storing of set temperature
    [Settings.cpp, Settings.h]
2020-10-05 Update esp-iot-base (fix epoch timer ISR crash)
    [main.cpp]
2020-10-05 Implement temperature offset handling
2020-10-05 Fix temperature handling in Blynk
2020-10-06 Adjust magnitude of temperature offset
2020-10-06 Add PrivateConfig sample
2020-10-06 Fix file name capitalization
    [Config.h, Extras.cpp, Extras.h, Keypad.h]
2020-10-06 Fix settings saving and loading
    [DS18B20.cpp, Settings.cpp, Settings.h]
2020-10-13 Add license info to TemperatureSensor
2020-10-13 Fix value roll-over in settings menu
    [Extras.h, main.cpp]
2020-10-13 Fix display of next state in Blynk
    [main.cpp]
2020-10-25 Attempt to fix zero degrees issue with enabled Blynk-over-SSL
    [main.cpp]
2020-12-21 Improve WiFi connection stability
    [main.cpp]
2020-12-21 Fix deactivation of Boost
    [main.cpp]
2020-12-31 Change device to ESP12E with proper settings
2020-12-31 Add Reboot option to the menu
    [main.cpp]
2021-01-04 Clamp temperature sensor reading
2021-01-04 Update esp-iot-base (Arduino OTA password hash)
2021-01-04 Add ArduinoOtaPasswordHash to PrivateConfig.h.sample
2021-06-22 Update Blynk to 1.0.0, pin pio platform to 2.x.x
2021-07-11 Update current temperature continuously
2021-08-18 Update esp-iot-base; pin platform dependency
2022-02-23 Make MQTT switchable from config
2022-03-05 Fix boost active status on MQTT after remote activation
    [main.cpp]
2023-11-03 Add active temperature and heating state entity
2023-11-04 Initial commit of HeatingZoneController
2023-11-04 Add HeatingZoneController tests
2023-11-05 Implement Boost in HeatingZoneController
2023-11-05 Implement basic control in HeatingZoneController
2023-11-05 Organize HeatingZoneController tests
2023-11-05 Add mode transition tests to HeatingZoneController
2023-11-05 Add Boost transition tests to HeatingZoneController
2023-11-06 Implement scheduler in HeatingZoneController
2023-11-07 Start implementing HeatingZone
2023-11-07 Initial commit of HeatingController and FurnaceController
2023-11-07 Implement MQTT integration in HeatingZone
2023-11-08 Update heating state when input parameters change
2023-11-08 Remove old heating controller
2023-11-26 Save the default state after failed load
    [HeatingZone.cpp, HeatingZone.h, main.cpp]
2023-11-26 Fix out-of-bounds write in Setting
    [FurnaceController.cpp, FurnaceController.h]
2023-11-26 Start implementing a proper MQTT device
2024-03-23 Implement window sensor handling
2024-03-23 Fix swapped window state handling
    [HeatingZone.cpp]
2024-03-23 Use switch config for Remote Window Sensor
2024-03-23 Add heating zone
2024-03-26 Implement open window lock-out
    Avoids calling for heat for the specified time after
    the window sensor indicates a 'Closed' state.
    [HeatingZone.cpp, HeatingZone.h, main.cpp]
2024-04-06 Create separate devices for individual zones
2024-05-09 Implement heating start delay
2024-09-26 Implement new settings with fixed memory layout
    [FurnaceController.cpp, FurnaceController.h, HeatingZone.cpp, HeatingZone.h, Settings.cpp, Settings.h, TemperatureSensor.cpp]
2024-09-26 Re-enable automatic display power saver
2024-09-26 Implement adjustable log level filter
2024-09-28 Disable debug mode zone temperature input
2024-09-29 Add missing WindowOpen state to zone status
    [FurnaceController.cpp]
2024-09-30 Fix static analysis issues
    [HeatingZone.cpp, HeatingZone.h]
2024-10-01 Use manual menu capacity for memory efficiency
    Revert back to require setting the capacity
    manually in a template parameter instead of
    a variant with a specified maximum count.
    This saves around 240 Bytes of RAM.
2024-10-06 Fix scrolling of long menus
    In case of menus with more items than the number of displayed items
    (height), stepping down to a point where the menu began scrolling, then
    stepping up and stepping down again, caused the menu to draw the wrong
    items beginning from the current position.
2024-10-06 Add input checks to HeatingZoneController
    To fix a possible oscillation scenario when over/undershoot is 0, add
    limits to hysteresis values. Also clamp the target temperature to avoid
    overheating or letting the room freeze.
2025-05-07 Avoid calling for heat if master switch is off
    [FurnaceController.cpp, HeatingZone.cpp, HeatingZone.h, main.cpp]
2026-02-01 Ignore start delay on temperature override
